WWU-Robotics-Club/Rover/README.md

# Rover

A robotic rover project.

See the wiki for more info: https://gitlab.cs.wallawalla.edu/robotics-club/Rover/-/wikis/home
