WWU-Robotics-Club/Rover/3D Parts/readme.md

## realsense mount 1 v1.stl

A simple mount for the Realsense Camera

## Rover nose v1.f3d

Includes the part to mount the RealSense Camera and wireless charging receiver coil, and the docking station transmitter coil mount.
