WWU-Robotics-Club/Rover/3D Parts/realsense mount 1 v1.stl

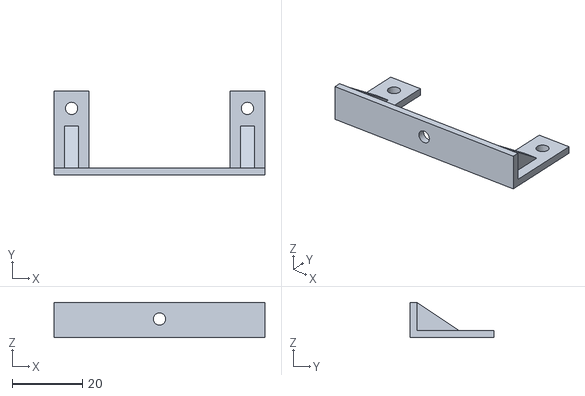
[picture p1: CAD file, 2020-06-12]
3D Parts/realsense mount 1 v1.stl
60.0 x 24.0 x 10.0
