WWU-Robotics-Club/Rover/(list of files, cad)

Other CAD files:
3D Parts/Rover nose v1.f3d
