WWU-Robotics-Club/Rover/Schematics/motor-driver/schematic.pdf

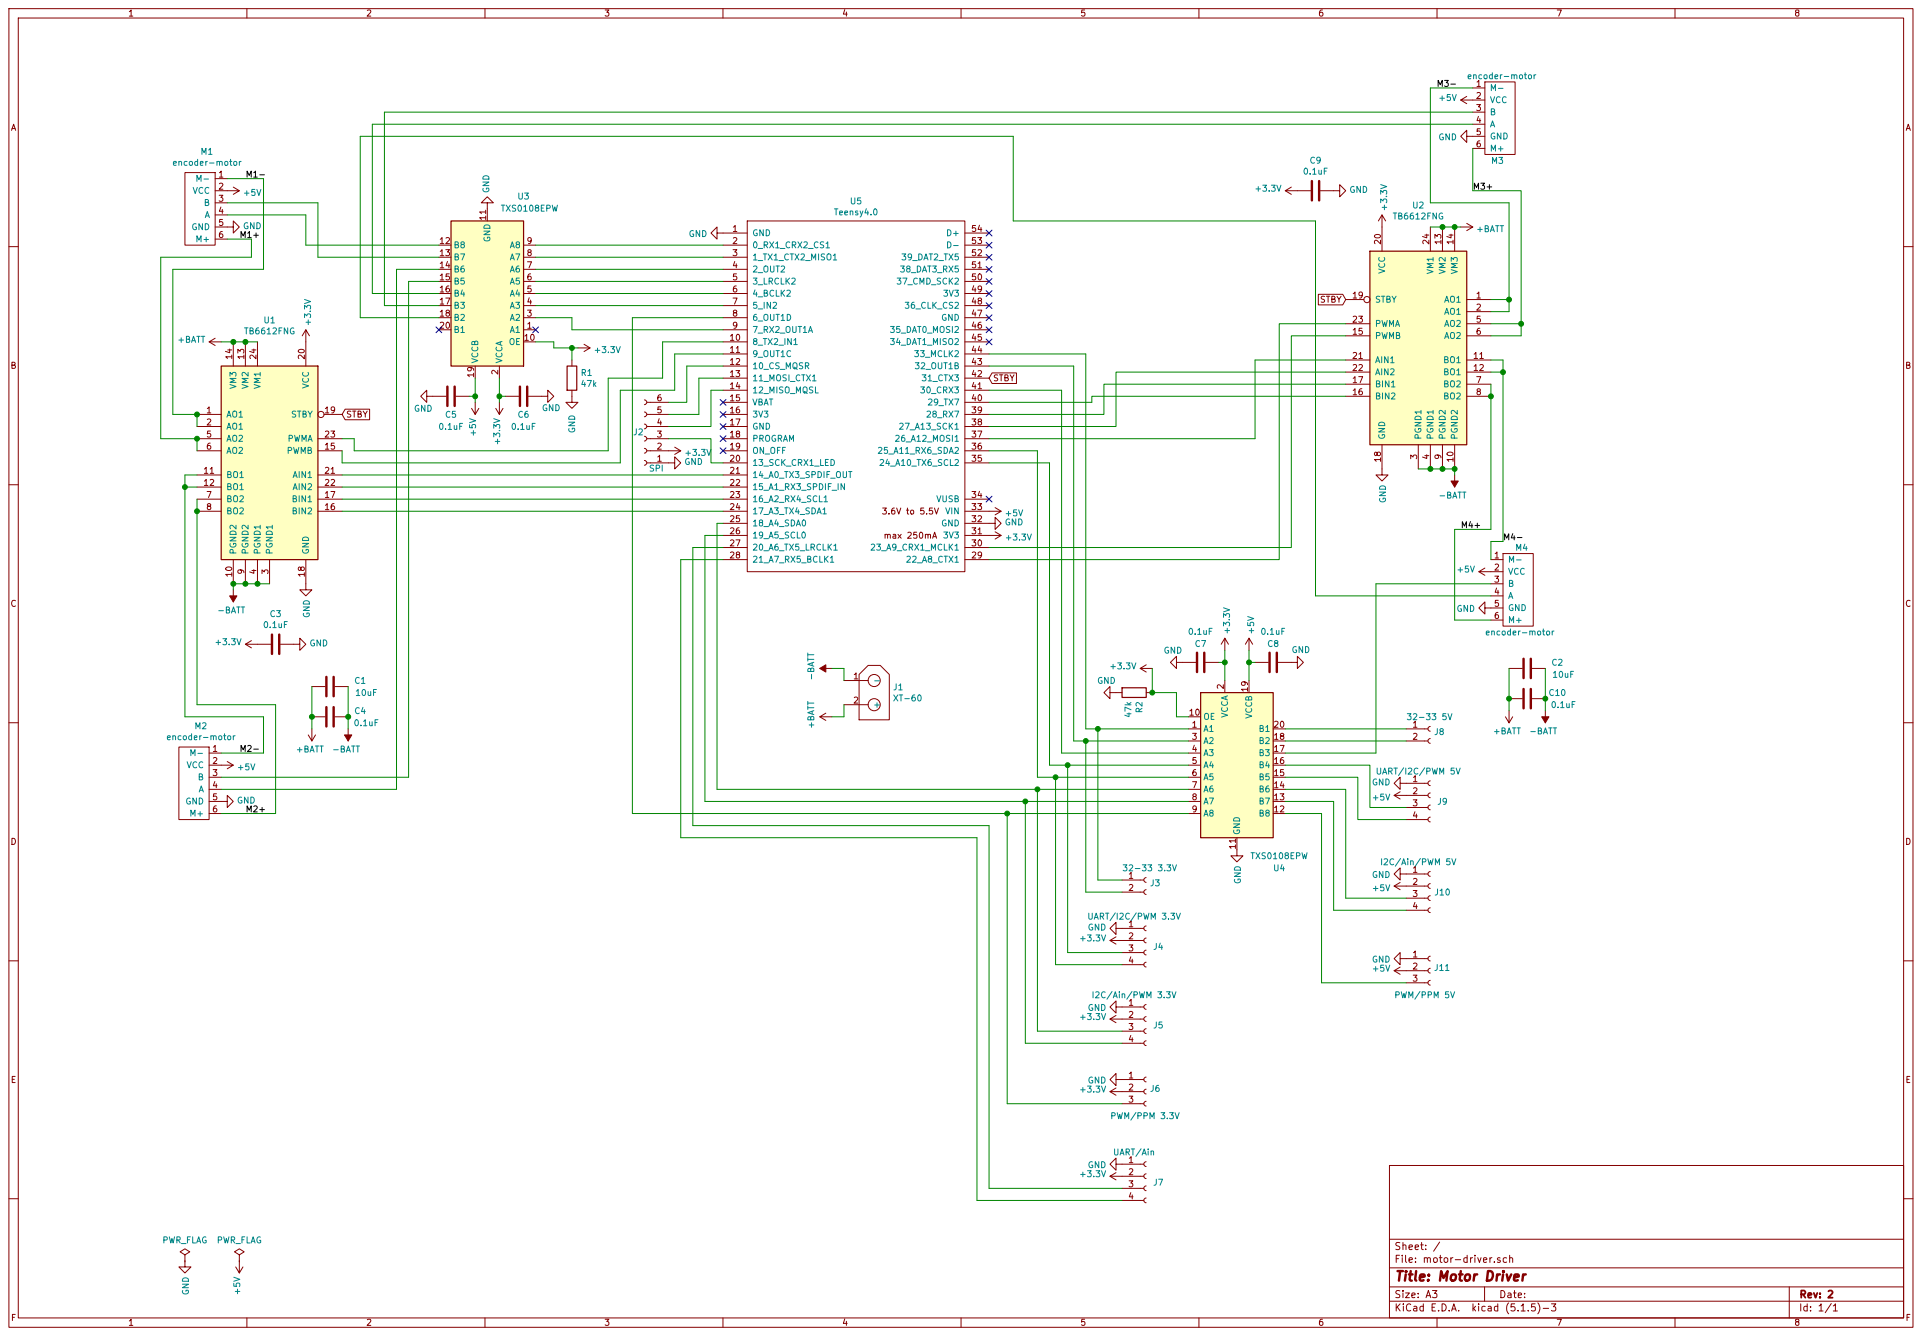
[picture p2: page 1]
