WWU-Robotics-Club/Rover/Schematics/motor-driver/motor-driver.kicad_pcb

## KiCad design Schematics/motor-driver/motor-driver.kicad_pcb (2020-06-09)

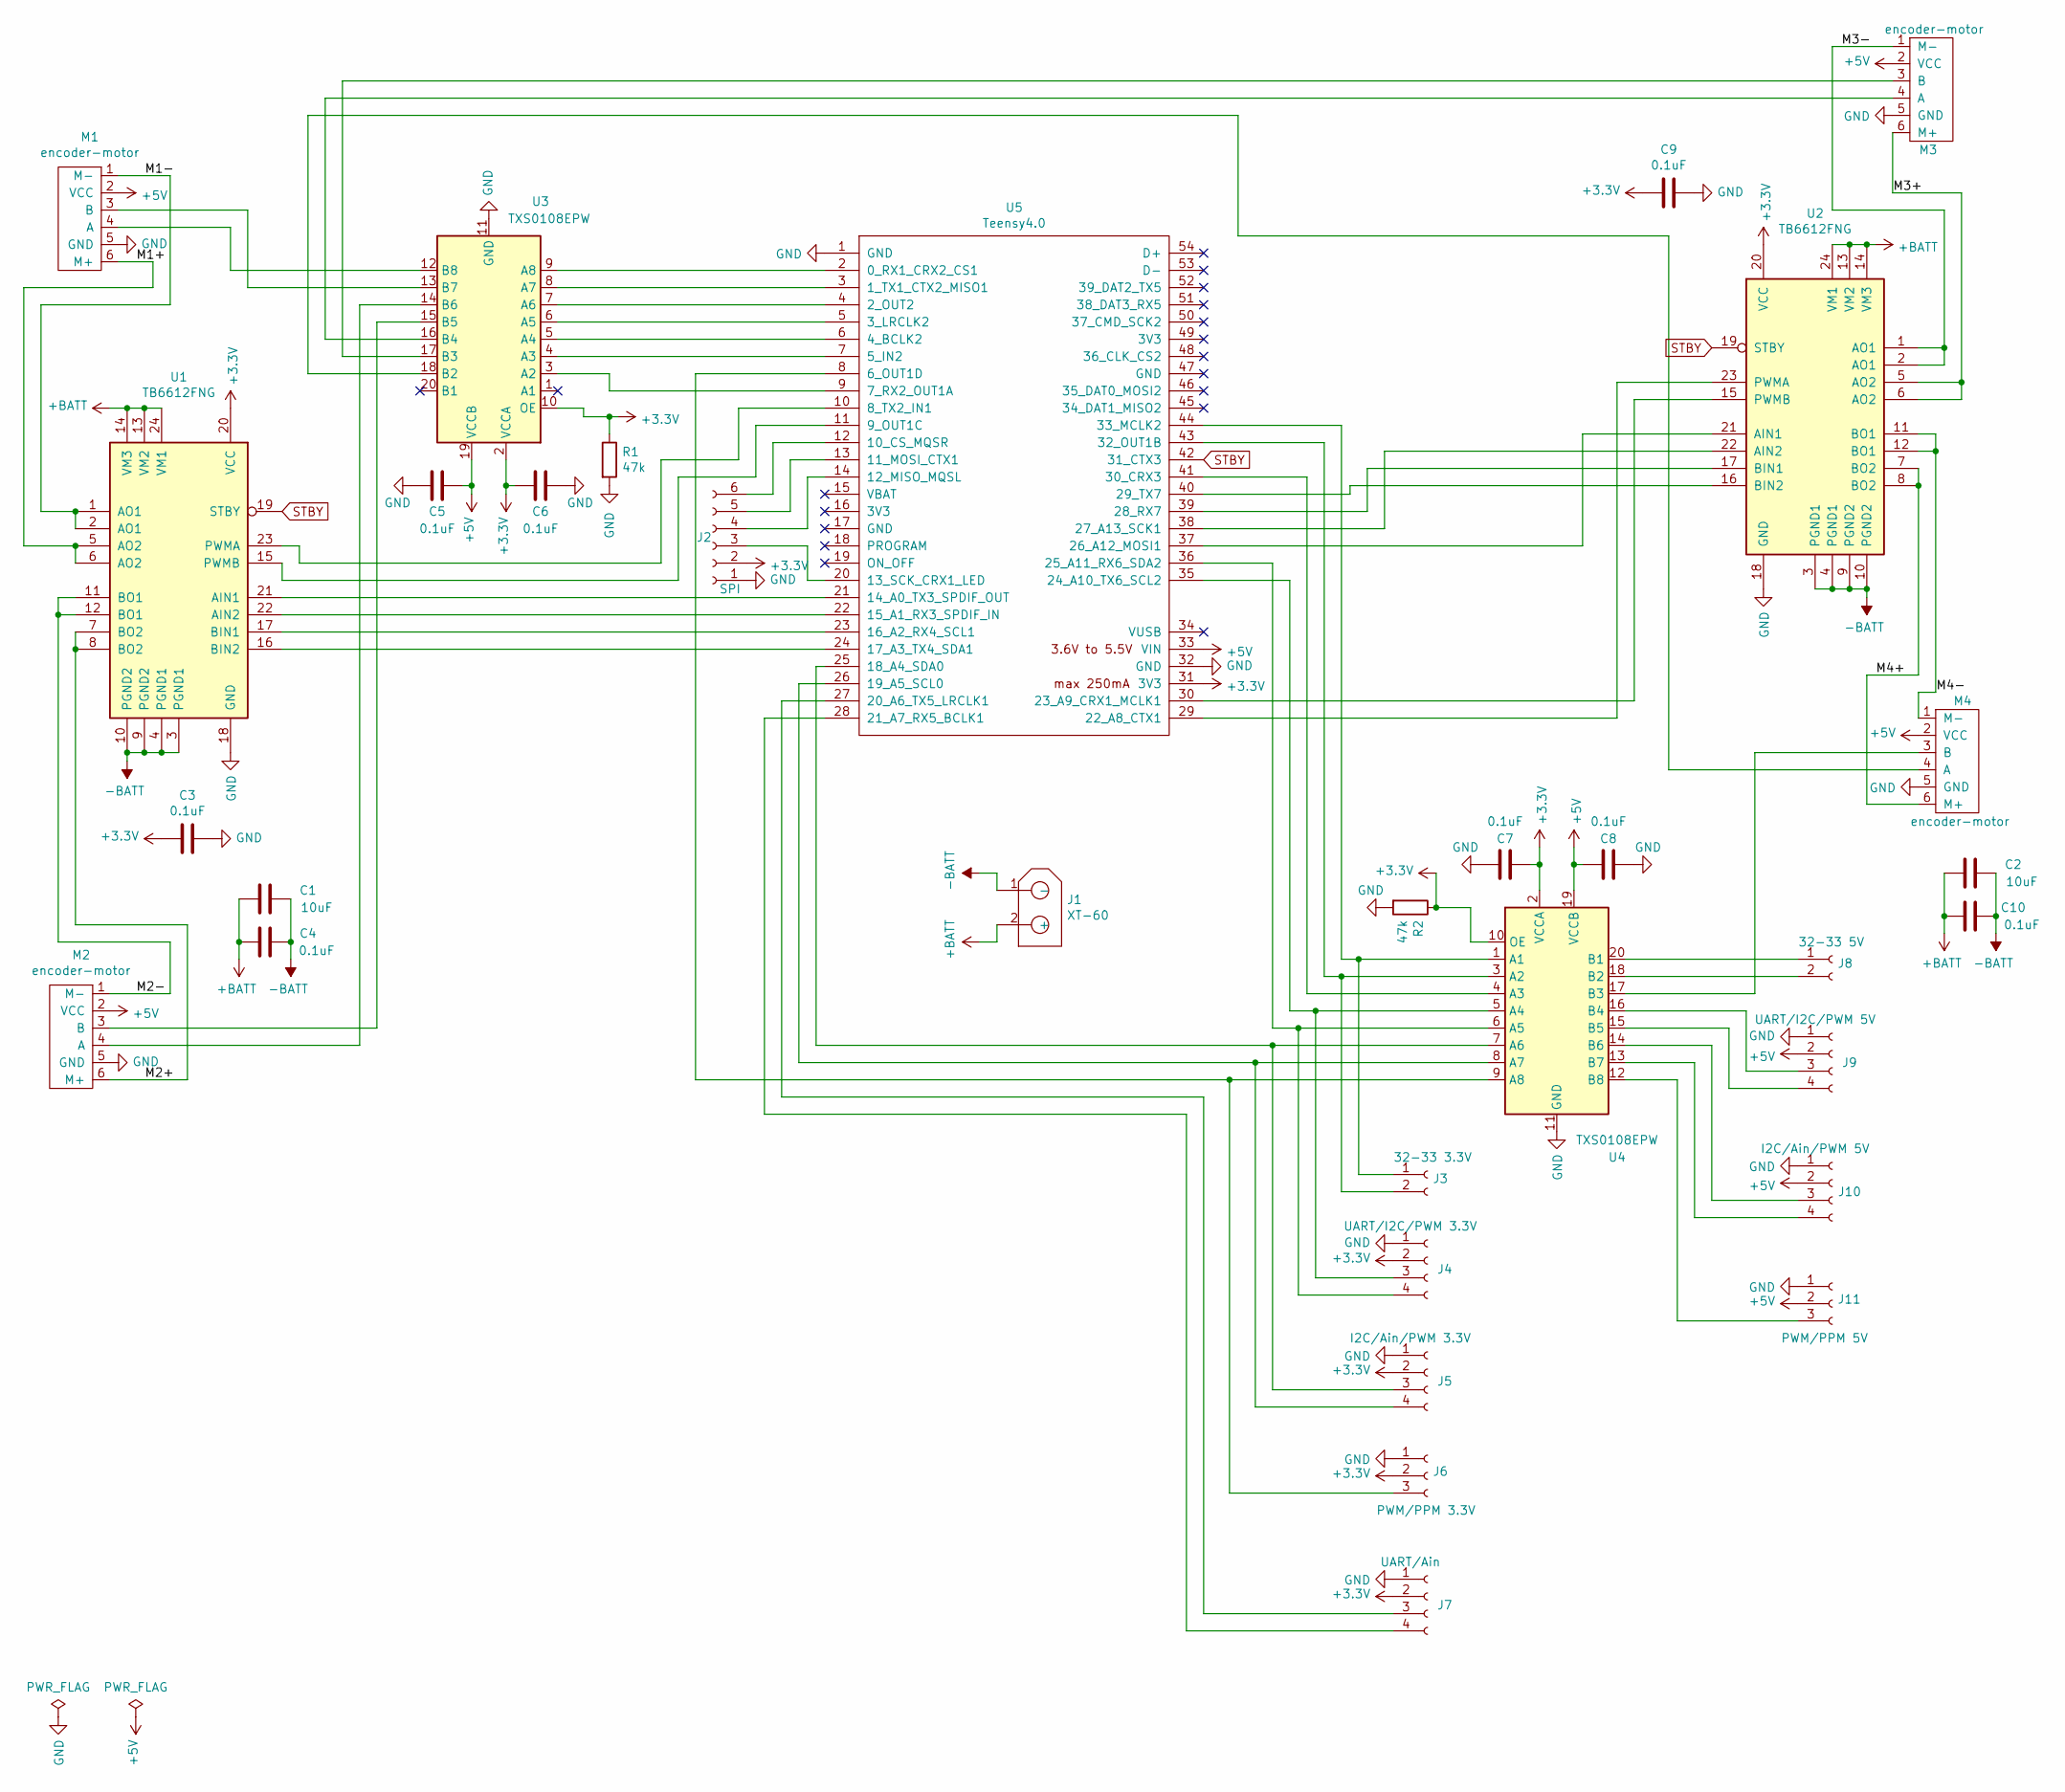
[picture p3: schematic motor-driver.sch]

Parts:
C1, C2: 10uF; C_1206_HandSoldering
C3, C4, C5, C6, C7, C8, C9, C10: 0.1uF; C_1206_HandSoldering
J1: XT-60; AMASS_XT60-M_1x02_P7.20mm_Vertical
J2: SPI; SPI_3.3V
J3: 32-33 3.3V; 32-33_3.3V
J4: UART/I2C/PWM 3.3V; UART_I2C_PWM_3.3V
J5: I2C/Ain/PWM 3.3V; I2C_Ain_PWM_3.3V
J6: PWM/PPM 3.3V; PPM_PWM_3.3V
J7: UART/Ain; UART_Ain_3.3V
J8: 32-33 5V; 32-33_5V
J9: UART/I2C/PWM 5V; UART_I2C_PWM_5V
J10: I2C/Ain/PWM 5V; I2C_Ain_PWM_5V
J11: PWM/PPM 5V; PPM_PWM_5V
M1, M2, M3, M4: encoder-motor; Motor_Header_Pitch2.54mm
R1, R2: 47k; R_0805_HandSoldering
U1, U2: TB6612FNG; SSOP-24_5.3x8.2mm_Pitch0.65mm
U3, U4: TXS0108EPW; TSSOP-20_4.4x6.5mm_Pitch0.65mm
U5: Teensy4.0; Teensy40

Connections:
+3V3: C3.2, C6.2, C7.2, C9.2, J2.2, J4.2, J5.2, J6.2, J7.2, R1.1, R2.1, U1.20 (VCC), U2.20 (VCC), U3.2 (VCCA), U3.10 (OE), U4.2 (VCCA), U4.10 (OE), U5.31 (3V3)
+5V: C5.1, C8.1, J9.2, J10.2, J11.2, M1.2 (VCC), M2.2 (VCC), M3.2 (VCC), M4.2 (VCC), U3.19 (VCCB), U4.19 (VCCB), U5.33 (VIN)
+BATT: C1.2, C2.2, C4.2, C10.2, J1.2 (+), U1.13 (VM2), U1.14 (VM3), U1.24 (VM1), U2.13 (VM2), U2.14 (VM3), U2.24 (VM1)
-BATT: C1.1, C2.1, C4.1, C10.1, J1.1 (-), U1.3 (PGND1), U1.4 (PGND1), U1.9 (PGND2), U1.10 (PGND2), U2.3 (PGND1), U2.4 (PGND1), U2.9 (PGND2), U2.10 (PGND2)
/M1+: M1.6 (M+), U1.5 (AO2), U1.6 (AO2)
/M1-: M1.1 (M-), U1.1 (AO1), U1.2 (AO1)
/M2+: M2.6 (M+), U1.7 (BO2), U1.8 (BO2)
/M2-: M2.1 (M-), U1.11 (BO1), U1.12 (BO1)
/M3+: M3.6 (M+), U2.5 (AO2), U2.6 (AO2)
/M3-: M3.1 (M-), U2.1 (AO1), U2.2 (AO1)
/M4+: M4.6 (M+), U2.7 (BO2), U2.8 (BO2)
/M4-: M4.1 (M-), U2.11 (BO1), U2.12 (BO1)
GND: C3.1, C5.2, C6.1, C7.1, C8.2, C9.1, J2.1, J4.1, J5.1, J6.1, J7.1, J9.1, J10.1, J11.1, M1.5 (GND), M2.5 (GND), M3.5 (GND), M4.5 (GND), R1.2, R2.2, U1.18 (GND), U2.18 (GND), U3.11 (GND), U4.11 (GND), U5.1 (GND), U5.32 (GND)
unnamed: J2.3, U5.20 (13_SCK_CRX1_LED)
unnamed: J2.4, U5.14 (12_MISO_MQSL)
unnamed: J2.5, U5.13 (11_MOSI_CTX1)
unnamed: J2.6, U5.12 (10_CS_MQSR)
unnamed: J3.1, U4.1 (A1), U5.44 (33_MCLK2)
unnamed: J3.2, U4.3 (A2), U5.43 (32_OUT1B)
unnamed: J4.3, U4.5 (A4), U5.35 (24_A10_TX6_SCL2)
unnamed: J4.4, U4.6 (A5), U5.36 (25_A11_RX6_SDA2)
unnamed: J5.3, U4.7 (A6), U5.25 (18_A4_SDA0)
unnamed: J5.4, U4.8 (A7), U5.26 (19_A5_SCL0)
unnamed: J6.3, U4.9 (A8), U5.8 (6_OUT1D)
unnamed: J7.3, U5.27 (20_A6_TX5_LRCLK1)
unnamed: J7.4, U5.28 (21_A7_RX5_BCLK1)
unnamed: J8.1, U4.20 (B1)
unnamed: J8.2, U4.18 (B2)
unnamed: J9.3, U4.16 (B4)
unnamed: J9.4, U4.15 (B5)
unnamed: J10.3, U4.14 (B6)
unnamed: J10.4, U4.13 (B7)
unnamed: J11.3, U4.12 (B8)
unnamed: M1.3 (B), U3.13 (B7)
unnamed: M1.4 (A), U3.12 (B8)
unnamed: M2.3 (B), U3.15 (B5)
unnamed: M2.4 (A), U3.14 (B6)
unnamed: M3.3 (B), U3.17 (B3)
unnamed: M3.4 (A), U3.16 (B4)
unnamed: M4.3 (B), U4.17 (B3)
unnamed: M4.4 (A), U3.18 (B2)
unnamed: U1.15 (PWMB), U5.11 (9_OUT1C)
unnamed: U1.16 (BIN2), U5.24 (17_A3_TX4_SDA1)
unnamed: U1.17 (BIN1), U5.23 (16_A2_RX4_SCL1)
unnamed: U1.21 (AIN1), U5.21 (14_A0_TX3_SPDIF_OUT)
unnamed: U1.22 (AIN2), U5.22 (15_A1_RX3_SPDIF_IN)
unnamed: U1.23 (PWMA), U5.10 (8_TX2_IN1)
unnamed: U2.15 (PWMB), U5.30 (23_A9_CRX1_MCLK1)
unnamed: U2.16 (BIN2), U5.40 (29_TX7)
unnamed: U2.17 (BIN1), U5.39 (28_RX7)
unnamed: U2.21 (AIN1), U5.37 (26_A12_MOSI1)
unnamed: U2.22 (AIN2), U5.38 (27_A13_SCK1)
unnamed: U2.23 (PWMA), U5.29 (22_A8_CTX1)
unnamed: U3.3 (A2), U5.9 (7_RX2_OUT1A)
unnamed: U3.4 (A3), U5.7 (5_IN2)
unnamed: U3.5 (A4), U5.6 (4_BCLK2)
unnamed: U3.6 (A5), U5.5 (3_LRCLK2)
unnamed: U3.7 (A6), U5.4 (2_OUT2)
unnamed: U3.8 (A7), U5.3 (1_TX1_CTX2_MISO1)
unnamed: U3.9 (A8), U5.2 (0_RX1_CRX2_CS1)
unnamed: U4.4 (A3), U5.41 (30_CRX3)
STBY: U1.19 (STBY), U2.19 (STBY), U5.42 (31_CTX3)

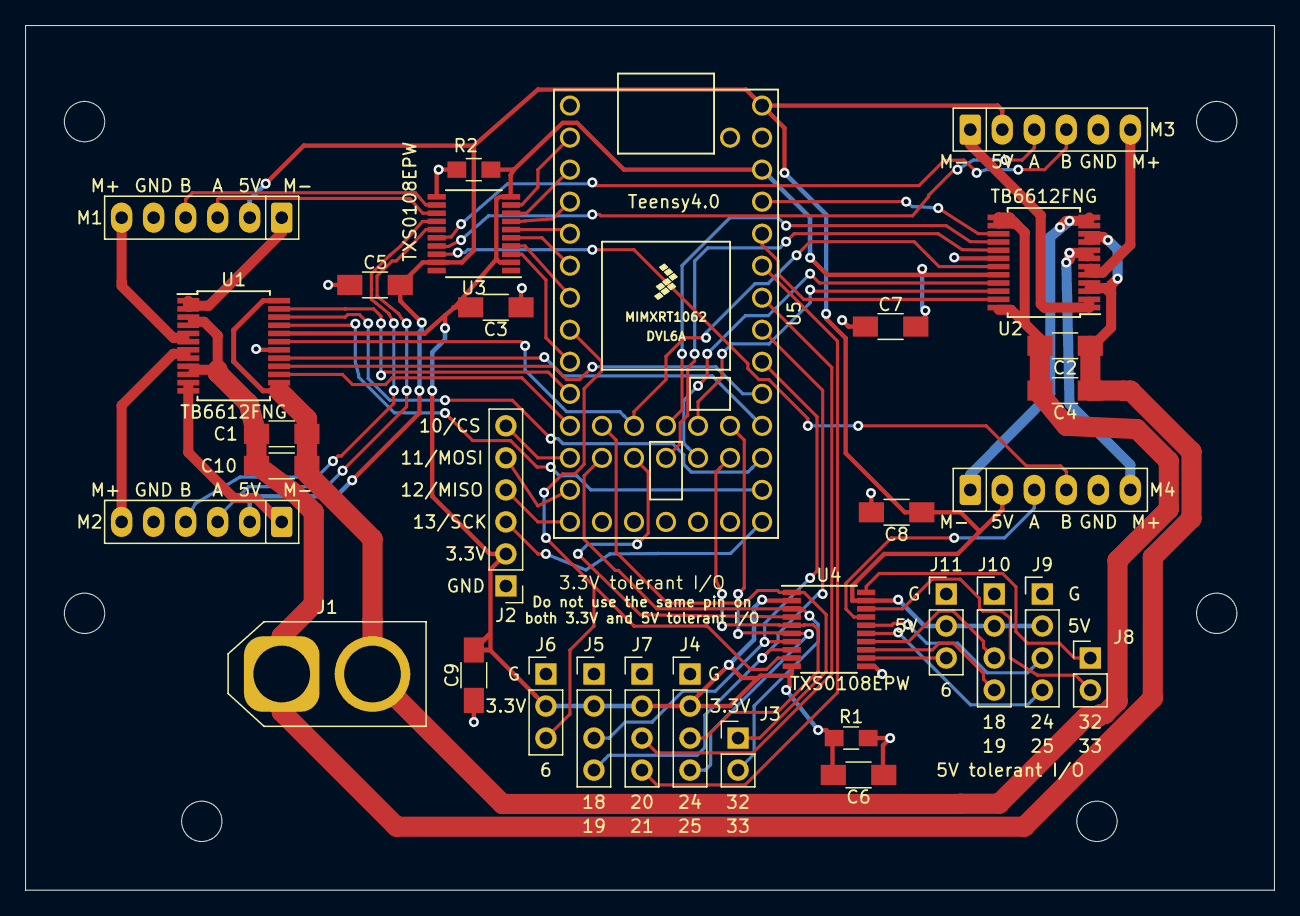
[picture p4: board motor-driver.kicad_pcb from above]

Board: 2 copper layers, 99.1 x 68.6 mm, 32 parts (0 on the bottom side), 62 nets.
