WWU-Robotics-Club/Rover/(threads)

Thread 1 (2019-09-24):

Mount wheels on motors

CalebJ2, 2019-09-24:
See https://github.com/WWU-Robotics-Club/Rover/wiki/Parts-list for specs

- [ ] Either buy parts that will work or design and fabricate some.
- [ ] Mount the wheels

Closed 2019-10-20.

Thread 2 (2019-09-24):

Create prototype base

CalebJ2, 2019-09-24:
Mostly done. Need to check progress.

CalebJ2, 2019-10-19:
Cut out a piece of plywood but we are using a kit now. See #18

Closed 2019-10-19.

Thread 4 (2019-09-24):

Get a motor spinning

CalebJ2, 2019-09-24:
Write a simple arduino sketch to control the motor driver and spin a motor.

CalebJ2, 2019-10-20:
Created another repository for the Arduino code because it seems like a separate thing. We could add it as a git submodule later if we want the code in this repo.

https://github.com/WWU-Robotics-Club/ROS-motor-control

CalebJ2, 2019-11-07:
Got a motor running using a TB6612 ( https://www.aliexpress.com/item/32903346167.html ) and this code:
`int speed = 0;
bool increasing = true;

void setup() {
  pinMode(1, OUTPUT);
  pinMode(2, OUTPUT);
  pinMode(3, OUTPUT);
  digitalWrite(1, HIGH);
  digitalWrite(2, LOW);
}

void loop() {
  // put your main code here, to run repeatedly:
  if (increasing)
  {
    speed += 5;
    if (speed > 250)
    {
      increasing = false;
      digitalWrite(1, LOW);
      digitalWrite(2, HIGH);
    }
  }
  else
  {
    speed -= 5;
    if (speed < -250)
    {
      increasing = true;
      digitalWrite(1, HIGH);
      digitalWrite(2, LOW);
    }
  }

  analogWrite(3, abs(speed));
  delay(30);
}`

CalebJ2, 2019-11-21:
Motor with encoder and PID:

    // https://www.pjrc.com/teensy/td_libs_Encoder.html
    #include <Encoder.h>

    Encoder encoder(11,12);
    double currentPos = 0;
    double previousPos = 0;
    float currentError = 0;
    float previousError = 0;
    double previousTime = 0;

    int stepsPerRev = 1435;

    float kp = 90;
    float ki = 100;
    float kd = 5;

    float errorIntegral = 0;
    float targetSpeed = 0.8;

    void setup() {
        Serial.begin(9600);
        Serial.println("Encoder Test:");
        // set up motor pins
        pinMode(1, OUTPUT);
        pinMode(2, OUTPUT);
        pinMode(3, OUTPUT);
        // enable going one direction
        digitalWrite(1, HIGH);
        digitalWrite(2, LOW);
    }

    void loop() {
        // put your main code here, to run repeatedly:
        previousPos = currentPos;
        currentPos = encoder.read();
        float dPos = (float)(currentPos-previousPos)/stepsPerRev; // revolutions

        double currentTime = millis();
        float dT = (currentTime-previousTime)/1000.0; // seconds
        previousTime = currentTime;

        float speed = dPos/dT;

        previousError = currentError;
        currentError = speed - targetSpeed;

        errorIntegral += currentError * dT;
        float errorDerivative = (currentError - previousError)/dT;

        float output = targetSpeed * kp - errorIntegral * ki - errorDerivative * kd;
        writeSpeed(output);
        Serial.println(String(speed) + "," + "," + String(errorIntegral));
        if (Serial.available()) {
            Serial.read();
            Serial.println("Reset to zero");
            encoder.write(0);
        }
        delay(10);
    }

    void writeSpeed(float speed) {
        if (speed > 0)
        {
            digitalWrite(1, LOW);
            digitalWrite(2, HIGH);
        }
        else {
            digitalWrite(1, HIGH);
            digitalWrite(2, LOW);
        }
        analogWrite(3, constrain(abs(speed),0,255));
    }

Thread 6 (2019-09-24):

Pick a battery

CalebJ2, 2019-09-24:
- [ ] Research what specs it needs
- [ ] Find a battery
- [ ] Purchase battery

GJessopIII, 2020-01-10:
Concluded that for now a 4000mAh lipo will suffice for our current needs

Thread 7 (2019-09-24):

Decide how to charge the battery

CalebJ2, 2019-09-24:
- [ ] Investigate docking methods & connectors
- [ ] Investigate putting the charger on board the rover vs at a base station
- [ ] Pick a charger

Thread 8 (2019-09-24):

Create a power distribution system

CalebJ2, 2019-09-24:
We need a way besides soldering of connecting things to the battery. On quadcopters they use PDBs (Power Distribution Boards) although those often use solder. Terminal blocks are an option. Something with connectors would be nice.

- [ ] Investigate methods of connecting many things to batteries
- [ ] Pick a method
- [ ] Get parts

Thread 14 (2019-09-25):

Create an example ROS topic for communicating with an arduino

CalebJ2, 2019-09-25:
This seems like a good way to start getting the hang of ROS.

CalebJ2, 2019-11-07:
Went through the rosserial arduino setup tutorial: http://wiki.ros.org/rosserial_arduino/Tutorials/Arduino%20IDE%20Setup
And the basic publisher tutorial: http://wiki.ros.org/rosserial_arduino/Tutorials/Hello%20World
Need to figure out why the ros_lib in the libraries folder isn't being recognized.

CalebJ2, 2019-11-22:
webhook test comment

khalilxl, 2020-01-10:
https://wiki.ros.org/rosserial_arduino/Tutorials/Servo%20Controller
We got this tutorial running to set the speed of the motor. We had to use this command to get it to run though on a different terminal.
`rosrun rosserial_arduino serial_node.py _port:=/dev/ttyUSB0`

The Arduino Serial Library cannot be used at the same time as the Arduino rosserial.

khalilxl, 2020-01-24:
#!/usr/bin/ env python

    import rospy
    from std_msgs.msg import String

    def talker():
        pub = rospy.Publisher('chatter', String, queue_size=10)
        rospy.init_node('talker', anonymous=True)
        rate = rospy.Rate(10)
        while not rospy.is_shutdown():
            test_str = input("Let get this tested out: ")
            rospy.loginfo(test_str)
            pub.publish(test_str)
            rate.sleep()
    if __name__ == '__main__':
        try:
            talker()
        except rospy.ROSInterruptException:
            pass

khalilxl, 2020-01-24:
#!/usr/bin/python
    import rospy
    from std_msgs.msg import String

    def callback(data):
        rospy.loginfo(rospy.get_caller_id() + "I heard %s", data.data)

    def listener():

        rospy.init_node('listener', anonymous=True)

        rospy.Subscriber("chatter", String, callback)

        rospy.spin()

    if __name__ == '__main__':
        listener()

Thread 17 (2019-10-04):

Investigate motors and drivers

CalebJ2, 2019-10-04:

CalebJ2, 2019-10-06:
This kit https://www.amazon.com/gp/product/B07PRW11VR/ has a brushed motors with quadrature encoders.
A driver like this could power them https://learn.adafruit.com/adafruit-motor-shield-v2-for-arduino although that is a little under powered.
I don't see many motor controllers that are made for using quadrature encoder and a reasonable price. Could read the encoders with an arduino: https://www.pjrc.com/teensy/td_libs_Encoder.html

CalebJ2, 2019-10-19:
The motors have this pinout: 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

CalebJ2, 2019-10-20:
I think 2 tb6612fng chips would work well for driving this: https://learn.sparkfun.com/tutorials/tb6612fng-hookup-guide/all

CalebJ2, 2019-11-21:
Encoder test script:

    // https://www.pjrc.com/teensy/td_libs_Encoder.html
    #include <Encoder.h>

    Encoder encoder(11,12);
    double previousPos = 0;
    double previousTime = 0;
    double currentPos = 0;

    void setup() {
        Serial.begin(9600);
        Serial.println("Encoder Test:");
    }

    void loop() {
        // put your main code here, to run repeatedly:
        previousPos = currentPos;
        currentPos = encoder.read();
        double currentTime = millis();
        float speed = (float)(currentPos-previousPos)/(float)(currentTime-previousTime);
        previousTime = currentTime;
        Serial.println(speed);
        if (Serial.available()) {
            Serial.read();
            Serial.println("Reset to zero");
            encoder.write(0);
        }
        delay(100);
    }

Thread 18 (2019-10-04):

Research existing kits

CalebJ2, 2019-10-04:

CalebJ2, 2019-10-04:
https://www.styknot.com/products/project-metal-encoder-robot-pie-ma--12v-platform---moebius-chassis-hall-wheel-for-mecanum-raspberry-arduino-robot-with-load-stm32-di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

CalebJ2, 2019-10-19:
We purchased the amazon kit

Closed 2019-10-19.

Thread 30 (2019-12-04):

Get a camera

CalebJ2, 2019-12-04:
Get a camera and create more issues for interfacing it to ROS
