WWU-Robotics-Club/Rover/(commit log)

2019-10-20 Add Arduino and Teensyduino to install script
    #16
2019-11-07 Add Arduino script submodule and rosserial submodule
    #14
2019-12-19 Give usb port access to user
    Fixes some arduino errors
    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
2020-01-24 Add motor driver schematic
    #4
    [motor-driver.kicad_pcb, motor-driver.sch]
2020-01-24 Add teensy kicad symbol submodule
    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
2020-01-24 Make library use relative url
    Change 3.3V to 5V
    [motor-driver.sch]
2020-01-26 Add motor driver pcb design
    Update schematics, add footprints, create pcb layout
    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
    [motor-driver.kicad_pcb, motor-driver.sch]
2020-01-31 Add mounting holes to PCB
    Update submodule remote
    Remove files that should just be wiki pages
    #28, #16
    [motor-driver.kicad_pcb]
2020-02-07 Add realsense packages to dockerfile
    Add arduino deploy stage
    #34
2020-03-01 Start on web interface
    Add nodejs web server and websocket relay to rosbridge
    Add rosbridge to launchfile
    Add nginx ssl proxy
    Add example roslibjs website
    Split usb portions of docker-compose into its own file
2020-03-05 Don't install debug symbols, mount all serial devices
    might change later but if the motor controleller wasn't plugged in it would error
2020-03-12 Start updating to use teensy 4.0
    Need to add level shifters
    [motor-driver.sch]
2020-03-15 Add some more footprints
2020-03-15 Update schematic and start on PCB layout
    [motor-driver.kicad_pcb, motor-driver.sch]
2020-03-16 Finish updating motor driver PCB for Teensy 4.0
    [motor-driver.kicad_pcb, motor-driver.sch]
2020-05-07 Add gerber files and update arduino code
2020-05-12 Update node image and motor control submodule
2020-05-21 Add joystick modes to webpage
    Make server side websocket auto-reconnect to ROS
    Update motor controller submodule
2020-06-12 Add files for 3d printing
    Gave schematic a title and saved a schematic PDF
    [Rover nose v1.f3d, motor-driver.sch, realsense mount 1 v1.stl]
